dennischang928/Robot-Sumo/Hardware/Circuit/BMS/README.md

# BMS

## List of Material

- JST-4-PTH
- Schottky diode 1N5819HW-7
- Pre-charge PMOS FDS4685
- Reverse polarity protection NMOS AO3400
- PESD12VL1BA
