dennischang928/Robot-Sumo/Hardware/CAD/Manufacture/CNC/LEFT.dxf

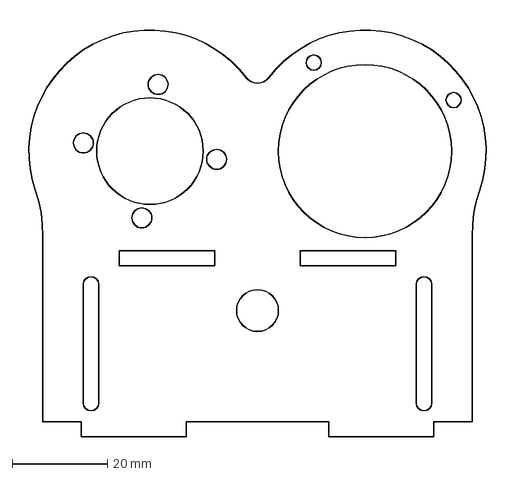
[picture p1: CAD file, 2023-05-18]
Hardware/CAD/Manufacture/CNC/LEFT.dxf
101.4 x 88.3 mm
