dennischang928/Robot-Sumo/Hardware/CAD/Manufacture/STL/Gear_2_be_Drive.stl

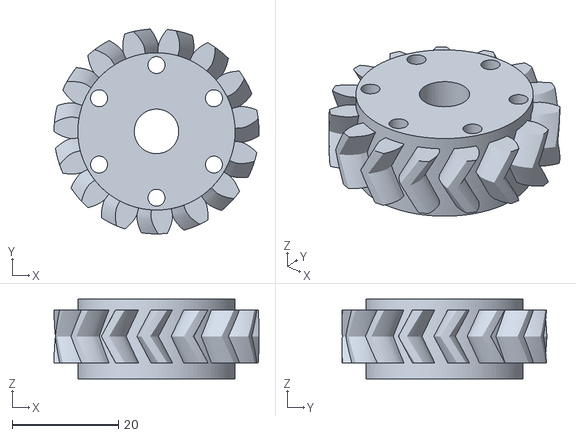
[picture p2: CAD file, 2023-05-18]
Hardware/CAD/Manufacture/STL/Gear_2_be_Drive.stl
38.6 x 38.6 x 15.0
