dennischang928/Robot-Sumo/Hardware/CAD/Manufacture/CNC/RIGHT.dxf

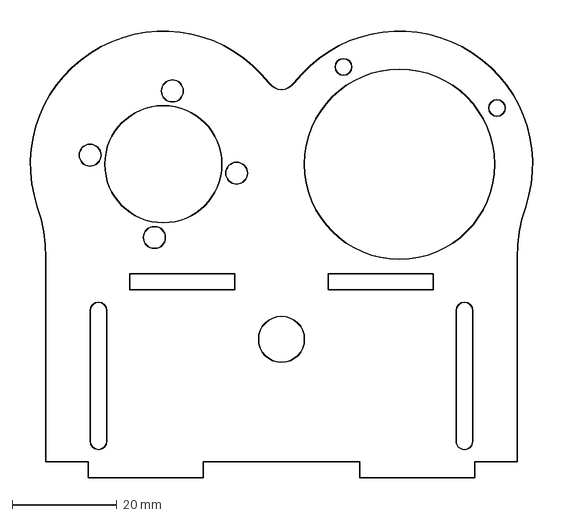
[picture p3: CAD file, 2023-05-18]
Hardware/CAD/Manufacture/CNC/RIGHT.dxf
101.4 x 88.3 mm
