dennischang928/Robot-Sumo/Hardware/CAD/Manufacture/STL/Motor_Gear(Drive Gear).stl

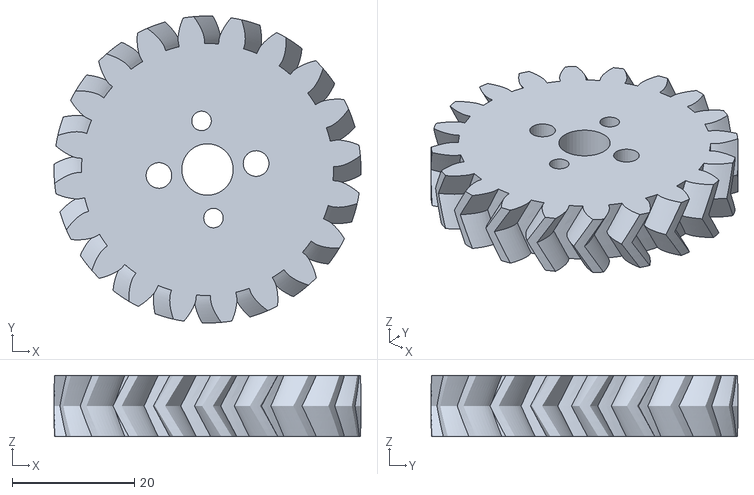
[picture p4: CAD file, 2023-05-18]
Hardware/CAD/Manufacture/STL/Motor_Gear(Drive Gear).stl
50.2 x 50.2 x 10.0
