dennischang928/Robot-Sumo/Hardware/CAD/Manufacture/STL/Wheel_Holder.stl

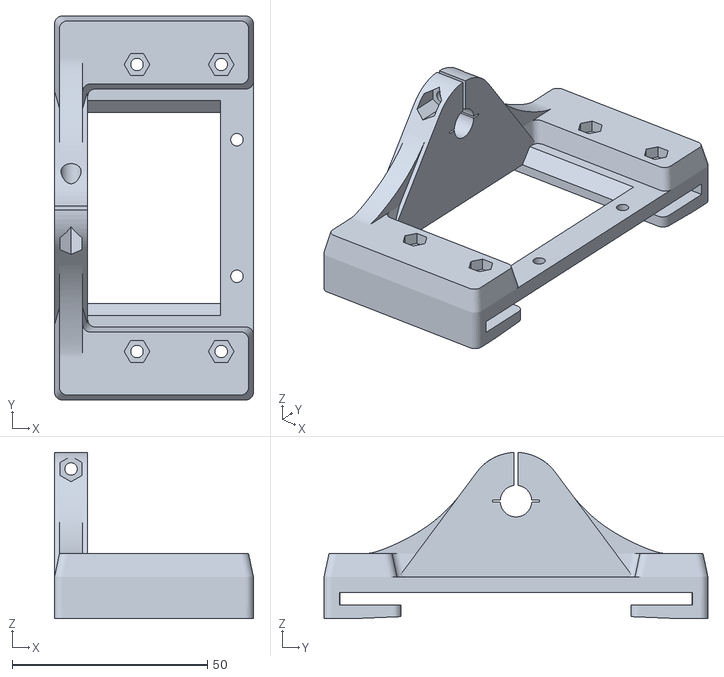
[picture p5: CAD file, 2023-05-18]
Hardware/CAD/Manufacture/STL/Wheel_Holder.stl
51.0 x 98.4 x 42.6
