dennischang928/Robot-Sumo/Hardware/CAD/Manufacture/CNC/Base.dxf

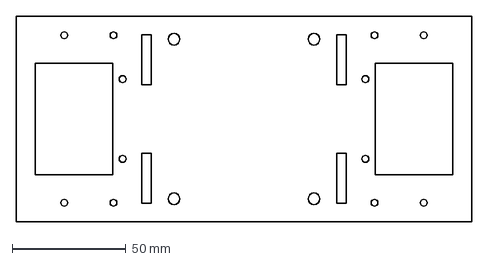
[picture p6: CAD file, 2023-05-18]
Hardware/CAD/Manufacture/CNC/Base.dxf
200.0 x 90.0 mm
