dennischang928/Robot-Sumo/Hardware/CAD/Manufacture/STL/Motor_Clamp.stl

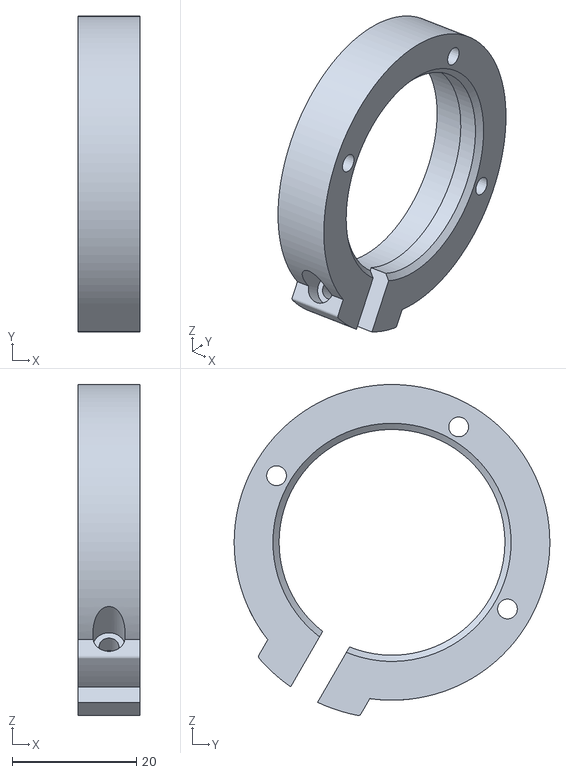
[picture p7: CAD file, 2023-05-18]
Hardware/CAD/Manufacture/STL/Motor_Clamp.stl
10.0 x 50.9 x 53.4
