dennischang928/Robot-Sumo/Hardware/CAD/Manufacture/CNC/Mid_part.dxf

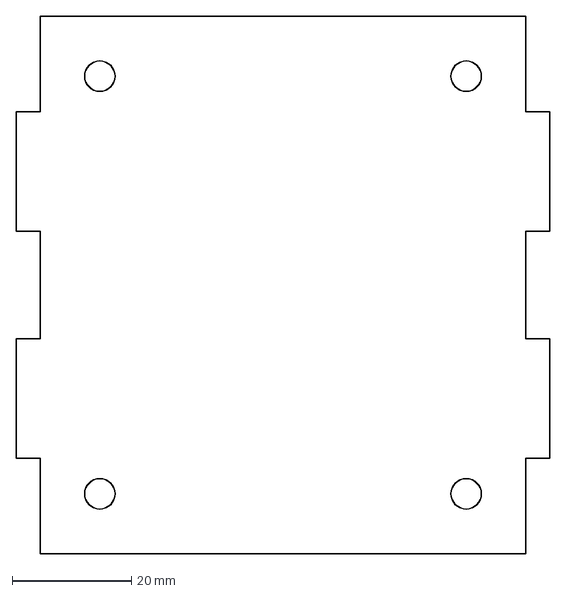
[picture p8: CAD file, 2023-05-18]
Hardware/CAD/Manufacture/CNC/Mid_part.dxf
89.4 x 90.0 mm
