dennischang928/Robot-Sumo/(list of files, cad)

Other CAD files:
Hardware/CAD/Manufacture/CNC/4mm.dwg
Hardware/CAD/Manufacture/CNC/3mm.dwg
