dennischang928/Robot-Sumo/Hardware/Circuit/SensorBrd/sch-SensorControlBrd v15.pdf

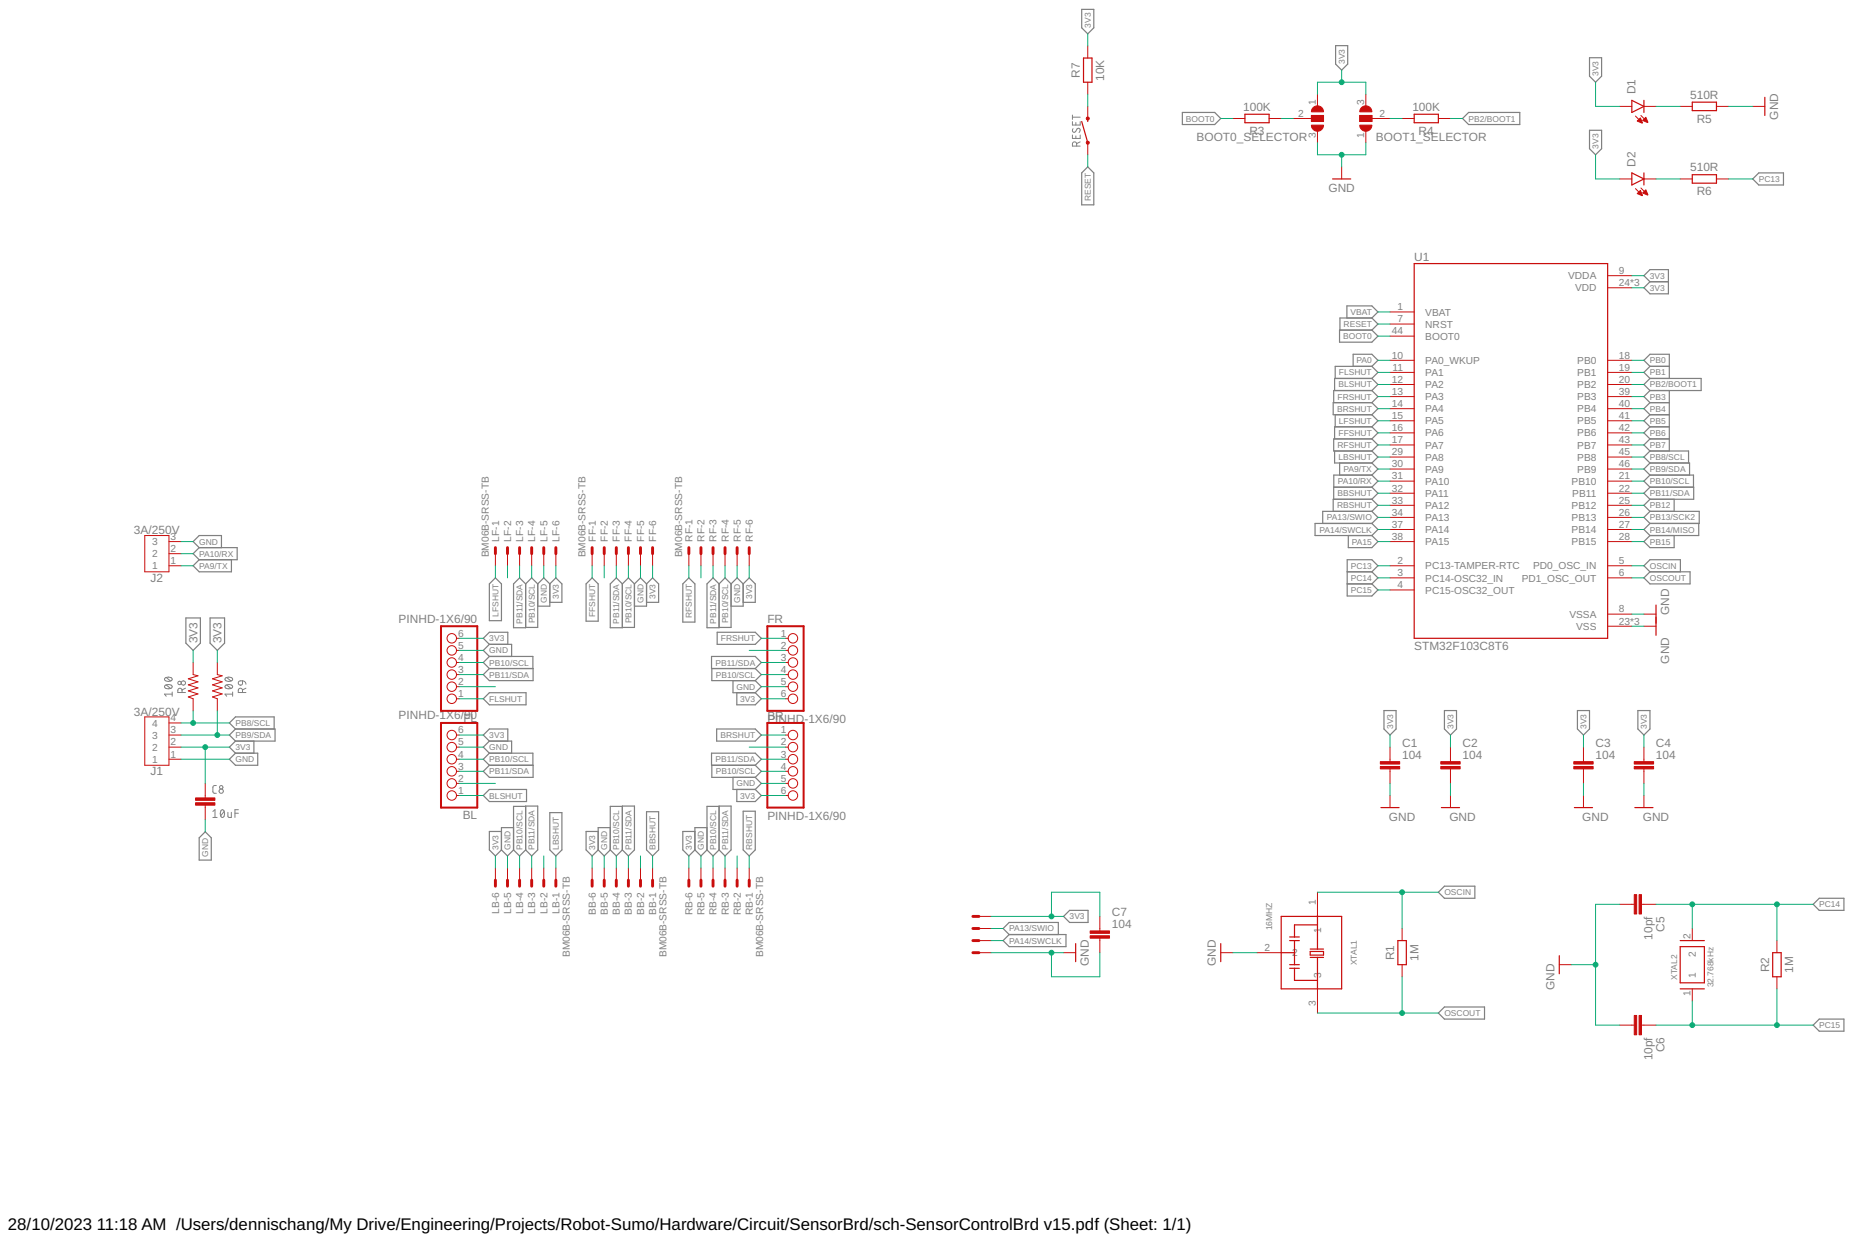
[picture p9: page 1]

28/10/2023 11:18 AM /Users/dennischang/My Drive/Engineering/Projects/Robot-Sumo/Hardware/Circuit/SensorBrd/sch-SensorControlBrd v15.pdf (Sheet: 1/1)
