dennischang928/Robot-Sumo/Hardware/Circuit/BMS/BMS_Schematic.pdf

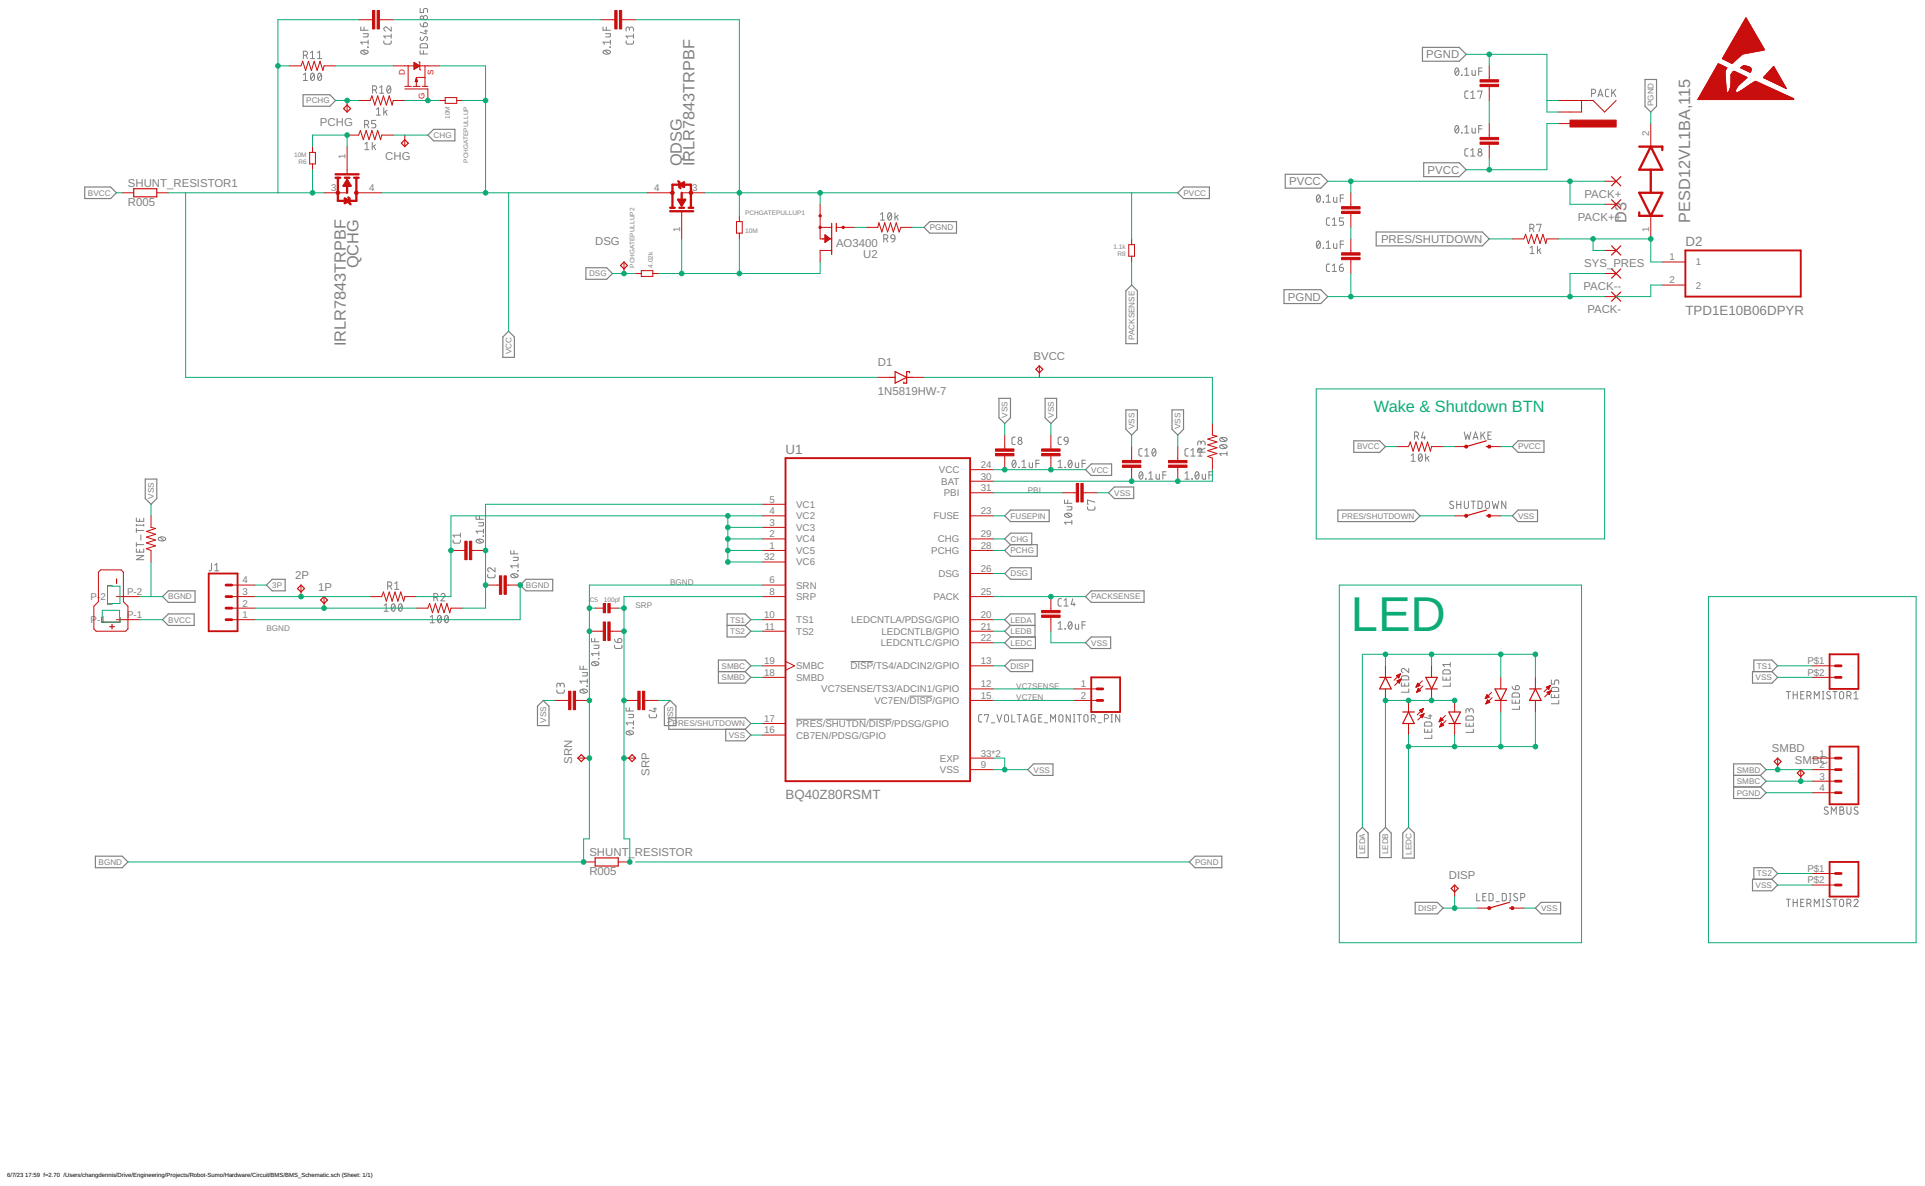
[picture p10: page 1]

6/7/23 17:59 f=2.70 /Users/changdennis/Drive/Engineering/Projects/Robot-Sumo/Hardware/Circuit/BMS/BMS_Schematic.sch (Sheet: 1/1)
