dennischang928/Robot-Sumo/Hardware/CAD/Manufacture/CNC/Assembly.pdf

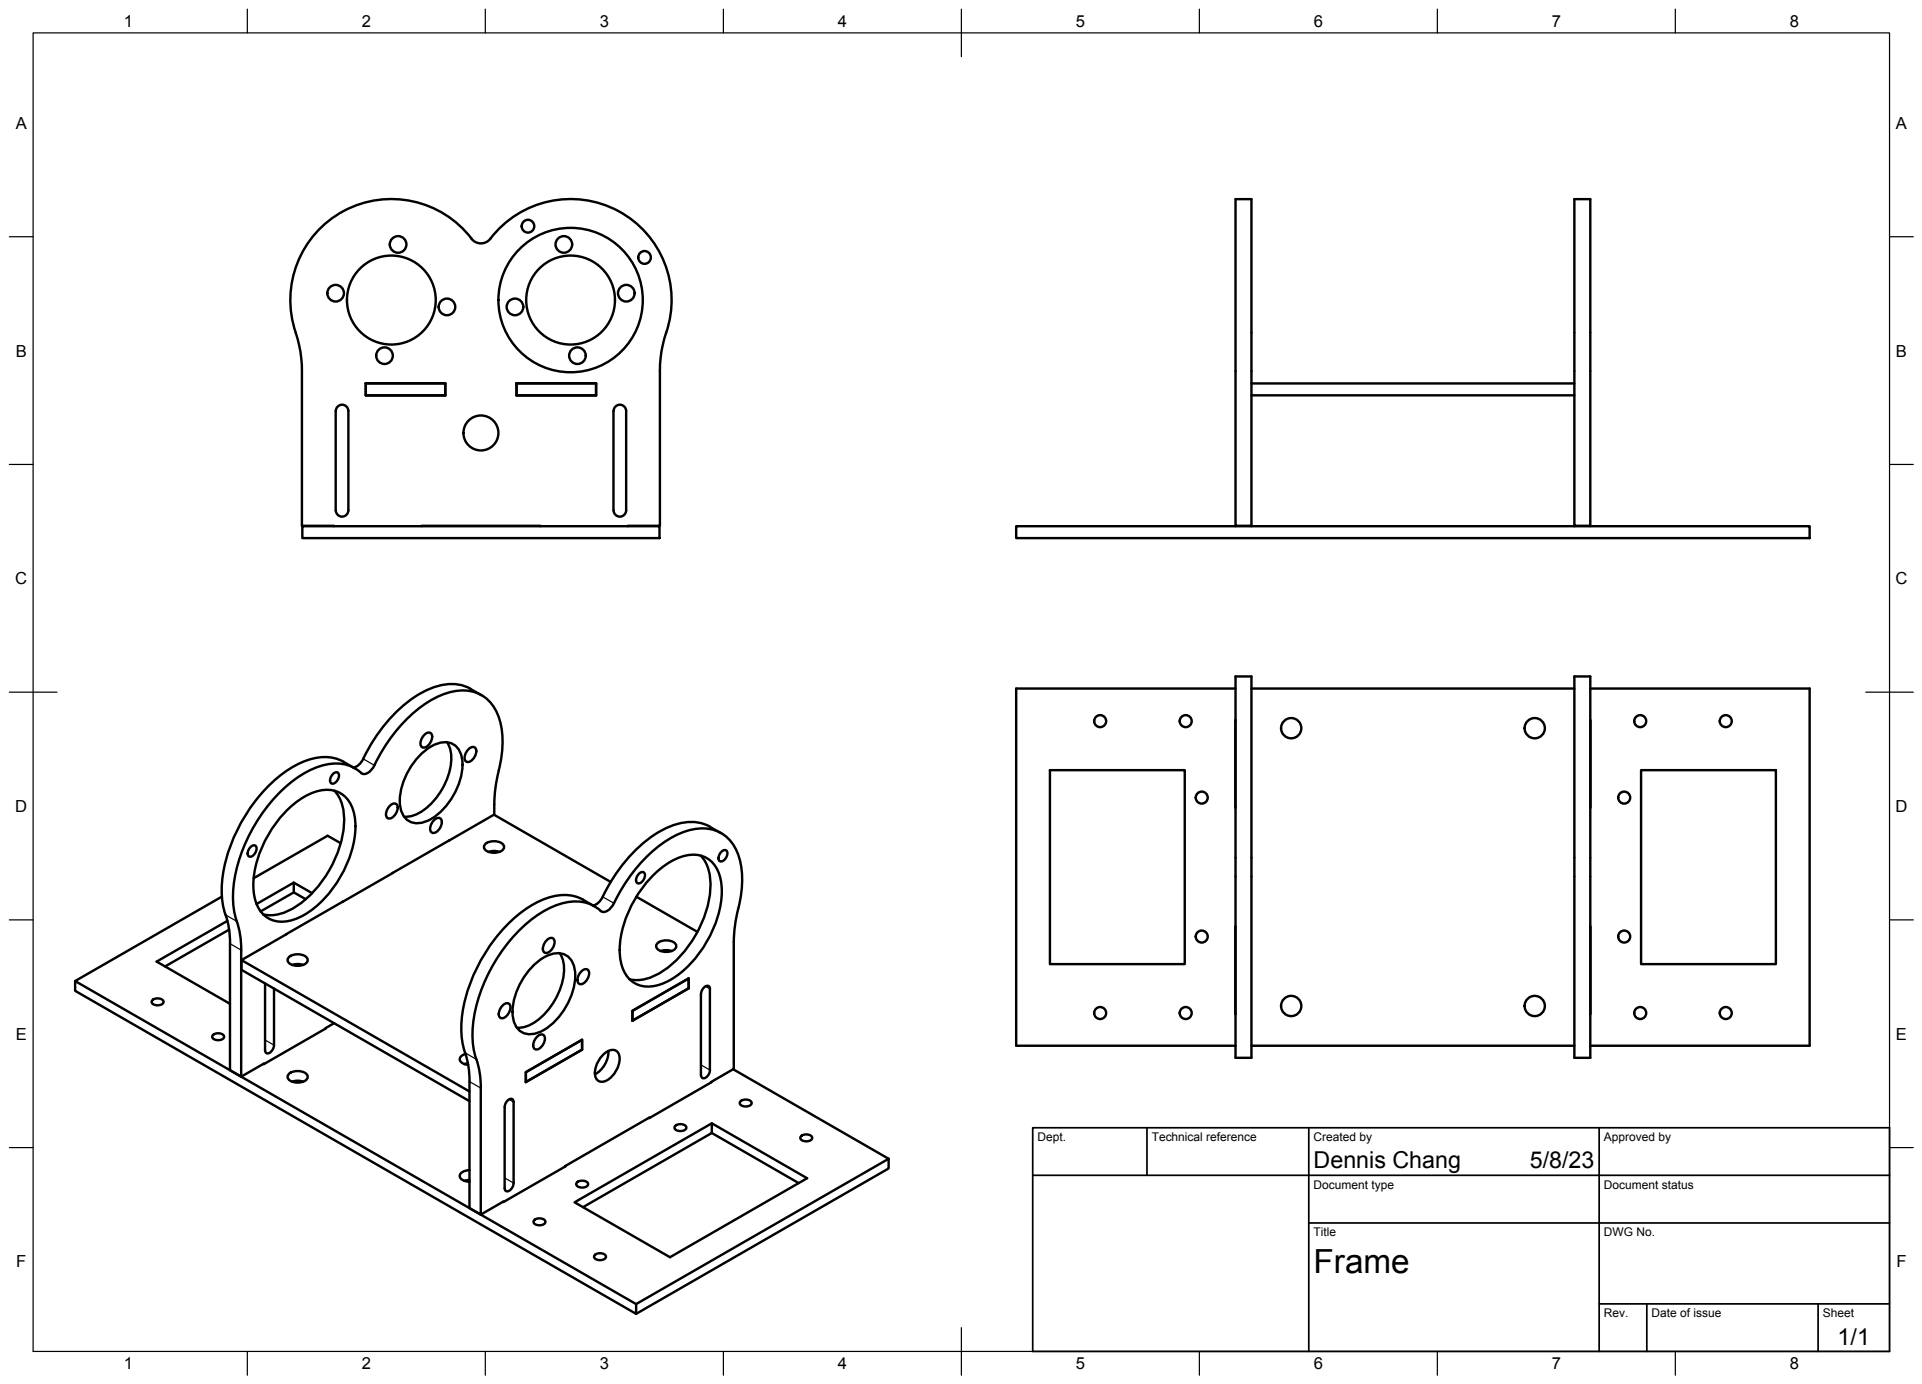
[picture p11: page 1]
Title; DWG No.; Rev.; Date of issue; Sheet

Dept. | Technical reference | Created by Dennis Chang 5/8/23 | Approved by

Document type | Document status
