dennischang928/Robot-Sumo/Hardware/Circuit/BMS/BMS_Schematic.brd

## EAGLE design Hardware/Circuit/BMS/BMS_Schematic.brd (2023-06-10)

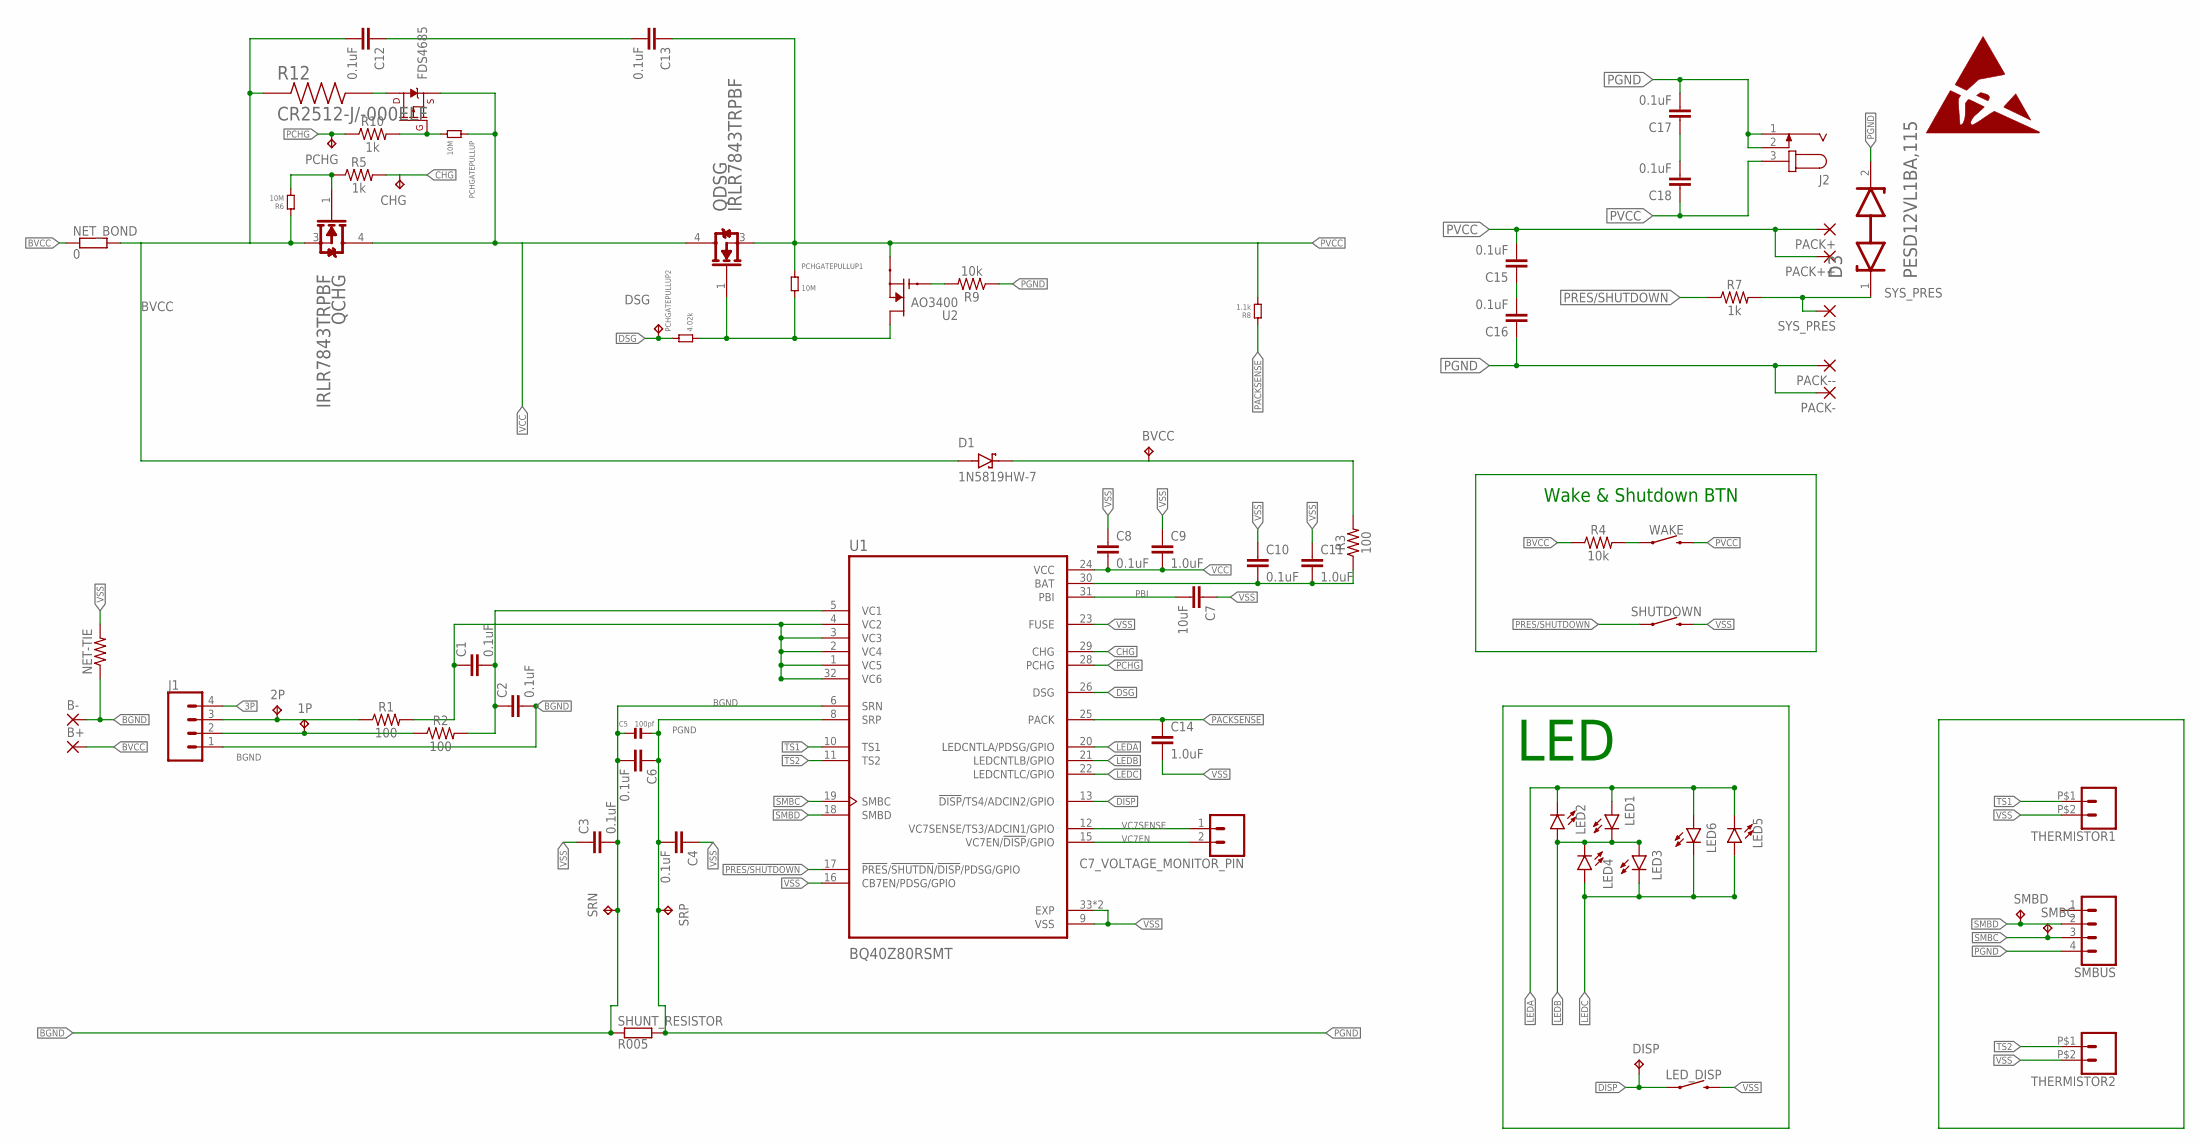
[picture p12: schematic BMS_Schematic.sch]

Parts:
1P, 2P: TPTP10R; TP10R
B+: WIREPADSMD5-2,5; 5-2,5
B-: WIREPADSMD5-2,5; 5-2,5
BVCC: TPTP10R; TP10R
C1, C2, C3, C4, C6, C8, C10, C12, C13, C15, C16, C17, C18: 0.1uF; 0603
C5: 100pf; 0805
C7: 10uF; 0603
C7_VOLTAGE_MONITOR_PIN: CONN_02; 1X02
C9, C11, C14: 1.0uF; 0603
CHG: TPTP10R; TP10R
D1: 1N5819HW-7; SOD3715X145N
D3: NEXPERIA_PESD12VL1BA,115NEXPERIA_PESD12VL1BA,115_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; NEXPERIA_PESD12VL1BA,115_0
DISP: TPTP10R; TP10R
DSG: TPTP10R; TP10R
J1: CONN_04JST-PTH; JST-4-PTH
J2: JACK-PLUG0; SPC4077
LED1, LED2, LED3, LED4, LED5, LED6: GREEN; LED-0603
LED_DISP: MOMENTARY-SWITCH-SPST-SMD-6.0X3.5MM; TACTILE_SWITCH_SMD_6.0X3.5MM
NET-TIE: 0; 0402-TIGHT
NET_BOND: 0; BVS
PACK+: WIREPADSMD5-2,5; 5-2,5
PACK++: WIREPADSMD5-2,5; 5-2,5
PACK-: WIREPADSMD5-2,5; 5-2,5
PACK--: WIREPADSMD5-2,5; 5-2,5
PCHG: TPTP10R; TP10R
PCHGATEPULLUP, PCHGATEPULLUP1: 10M; 0805
PCHGATEPULLUP2: 4.02k; 0805
QCHG: INFINEON_IRLR7843TRPBFINFINEON_IRLR7843TRPBF_0_0; INFINEON_IRLR7843TRPBF_0
QDSG: INFINEON_IRLR7843TRPBFINFINEON_IRLR7843TRPBF_0_0; INFINEON_IRLR7843TRPBF_0
R1, R2, R3: 100; 0603
R4, R9: 10k; 0603
R5, R7, R10: 1k; 0603
R6: 10M; 0805
R8: 1.1k; 0805
R12: CR2512-J/-000ELF; RESC6331X75N
SHUNT_RESISTOR: R005; BVS
SHUTDOWN: MOMENTARY-SWITCH-SPST-SMD-6.0X3.5MM; TACTILE_SWITCH_SMD_6.0X3.5MM
SMBC: TPTP10R; TP10R
SMBD: TPTP10R; TP10R
SMBUS: CONN_04JST-SMD-LOCKING; JST-4-SMD-1.25MM-LOCKING
SRN: TPTP10R; TP10R
SRP: TPTP10R; TP10R
SYS_PRES: SMD2; SMD1,27-2,54
THERMISTOR1, THERMISTOR2: SOLDER_PAD_2
U1: BQ40Z80RSMT; QFN40P400X400X100-33N
U2: AO3400; SOT23
U$2: FDS4685; SOIC127P600X150-8N
WAKE: MOMENTARY-SWITCH-SPST-SMD-6.0X3.5MM; TACTILE_SWITCH_SMD_6.0X3.5MM

Connections:
1P: C1.2, C2.1, R2.2, U1.5 (VC1)
2P: C1.1, R1.2, U1.1 (VC5), U1.2 (VC4), U1.3 (VC3), U1.4 (VC2), U1.32 (VC6)
3P: J1.4
BAT: C10.2, C11.2, R3.1, U1.30 (BAT)
BGND: B-.1, C2.2, C3.2, C5.1, C6.2, J1.1, NET-TIE.1, SHUNT_RESISTOR.2, SRN.TP, U1.6 (SRN)
BVCC: B+.1, C12.2, D1.A, NET_BOND.1, NET_BOND.2, QCHG.3 (SOURCE), R4.1, R6.1, R12.1
CHG: CHG.TP, R5.2, U1.29 (CHG)
DISP: DISP.TP, LED_DISP.1, U1.13 (!DISP!/TS4/ADCIN2/GPIO)
DSG: DSG.TP, PCHGATEPULLUP2.1, U1.26 (DSG)
LEDA: LED1.A, LED2.C, LED5.C, LED6.A, U1.20 (LEDCNTLA/PDSG/GPIO)
LEDB: LED1.C, LED2.A, LED3.A, LED4.C, U1.21 (LEDCNTLB/GPIO)
LEDC: LED3.C, LED4.A, LED5.A, LED6.C, U1.22 (LEDCNTLC/GPIO)
unnamed: R9.2, U2.1 (G)
unnamed: 2P.TP, J1.3, R1.1
unnamed: 1P.TP, J1.2, R2.1
unnamed: C12.1, C13.2
unnamed: BVCC.TP, D1.C (K), R3.2
unnamed: R12.2, U$2.5 (D), U$2.6 (D), U$2.7 (D), U$2.8 (D)
unnamed: PCHGATEPULLUP.2, R10.2, U$2.4 (G)
unnamed: QCHG.1 (GATE), R5.1, R6.2
unnamed: PCHGATEPULLUP1.2, PCHGATEPULLUP2.2, QDSG.1 (GATE), U2.3 (D)
unnamed: R4.2, WAKE.1
unnamed: C15.1, C16.2
unnamed: C17.1, C18.2
PACKSENSE: C14.1, R8.1, U1.25 (PACK)
PBI: C7.2, U1.31 (PBI)
PCHG: PCHG.TP, R10.1, U1.28 (PCHG)
PGND: C4.2, C5.2, C6.1, C16.1, C17.2, D3.2 (CATHODE_2), J2.1, J2.2, PACK-.1, PACK--.1, R9.1, SHUNT_RESISTOR.1, SMBUS.4, SRP.TP, U1.8 (SRP)
PRES/SHUTDOWN: R7.1, SHUTDOWN.1, U1.17 (!PRES!/!SHUTDN!/!DISP!/PDSG/GPIO)
PVCC: C13.1, C15.2, C18.1, J2.3, PACK+.1, PACK++.1, PCHGATEPULLUP1.1, QDSG.3 (SOURCE), R8.2, U2.2 (S), WAKE.2
SMBC: SMBC.TP, SMBUS.3, U1.19 (SMBC)
SMBD: SMBD.TP, SMBUS.2, U1.18 (SMBD)
SYS_PRES: D3.1 (CATHODE_1), R7.2, SYS_PRES.1
TS1: THERMISTOR1.P$1 (1), U1.10 (TS1)
TS2: THERMISTOR2.P$1 (1), U1.11 (TS2)
VC7EN: C7_VOLTAGE_MONITOR_PIN.2, U1.15 (VC7EN/!DISP!/GPIO)
VC7SENSE: C7_VOLTAGE_MONITOR_PIN.1, U1.12 (VC7SENSE/TS3/ADCIN1/GPIO)
VCC: C8.2, C9.2, PCHGATEPULLUP.1, QCHG.4 (DRAIN), QDSG.4 (DRAIN), U1.24 (VCC), U$2.1 (S), U$2.2 (S), U$2.3 (S)
VSS: C3.1, C4.1, C7.1, C8.1, C9.1, C10.1, C11.1, C14.2, LED_DISP.2, NET-TIE.2, SHUTDOWN.2, THERMISTOR1.P$2 (2), THERMISTOR2.P$2 (2), U1.9 (VSS), U1.16 (CB7EN/PDSG/GPIO), U1.23 (FUSE), U1.33 (EXP), U1.33_1 (EXP)

Notes on the sheet:
LED
Wake & Shutdown BTN

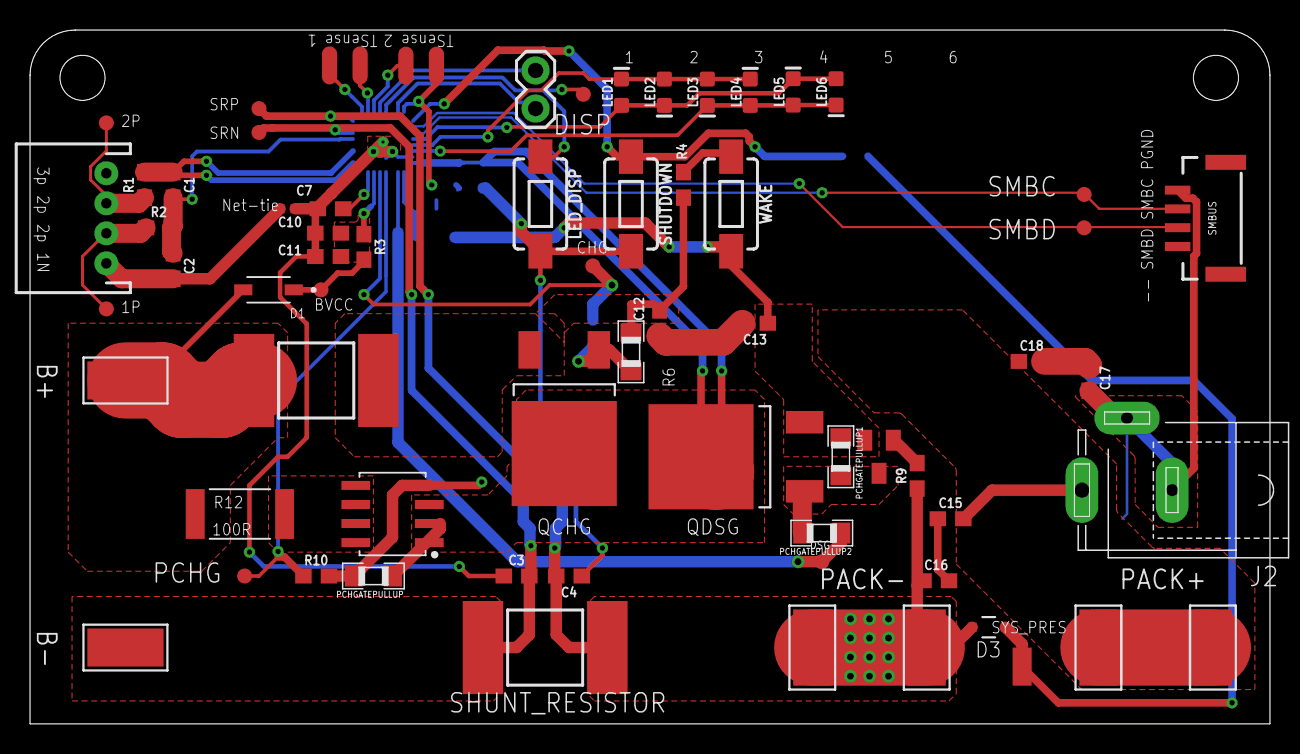
[picture p13: board BMS_Schematic.brd from above]

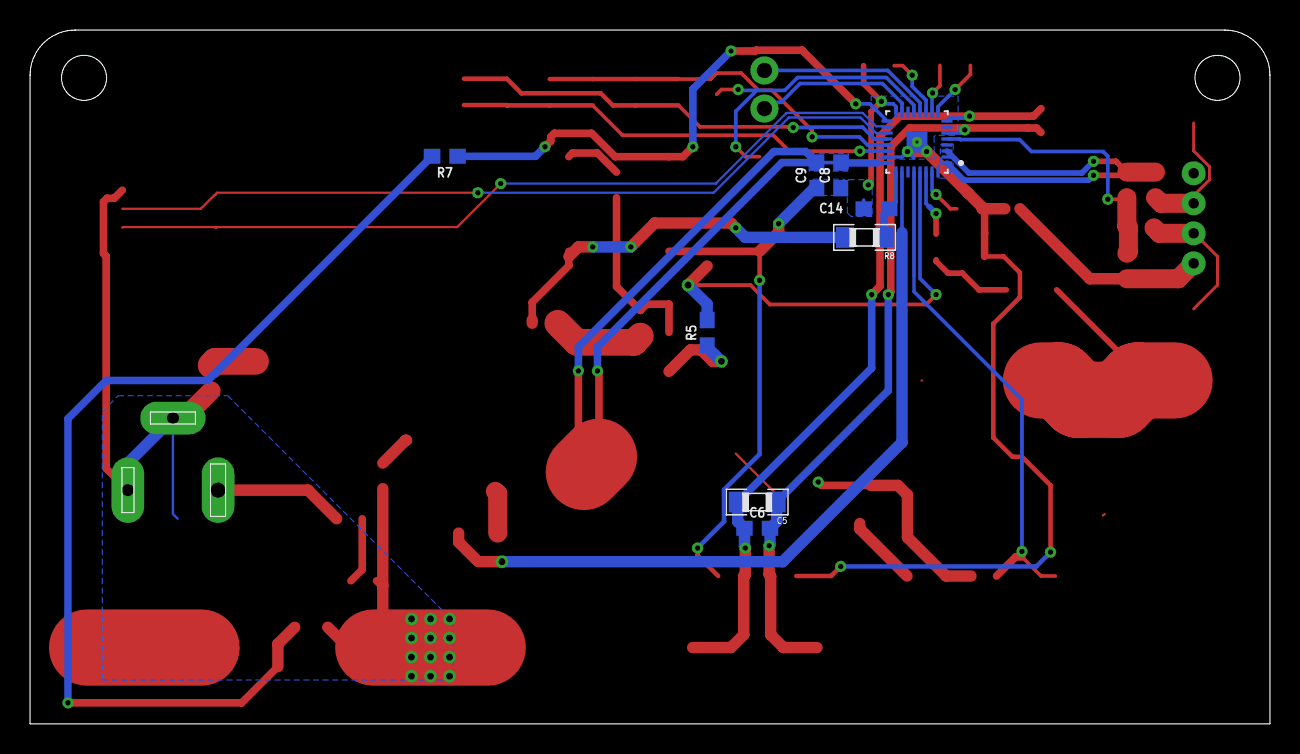
[picture p14: board BMS_Schematic.brd from below]

Board: 2 copper layers, 82.5 x 46.2 mm, 75 parts (9 on the bottom side), 38 nets.
