dennischang928/Robot-Sumo/Software/Tests/VL53l1x-Test/Core/Src/main.c

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
/* Includes ------------------------------------------------------------------*/
#include "main.h"

/* USER CODE BEGIN Includes */
#include "VL53L1X_api.h"
#include <stdbool.h>

/* USER CODE END Includes */

/* USER CODE BEGIN PD */
#define SensorNumber 1
/* USER CODE END PD */

I2C_HandleTypeDef hi2c2;

UART_HandleTypeDef huart1;

/* USER CODE BEGIN PV */

VL53L1_Dev_t devs[SensorNumber];
uint8_t		DevicesAddresses[SensorNumber] = {0x50, 0x02};
int			status = 0;

uint8_t		sensorState = 0;
uint16_t Distance;
uint16_t SignalRate;
uint16_t AmbientRate;
uint16_t AmbientPerSpad;
uint8_t RangeStatus;
/* USER CODE END PV */

void	SystemClock_Config(void);
static void	MX_GPIO_Init(void);
static void	MX_USART1_UART_Init(void);
static void	MX_I2C2_Init(void);
/* USER CODE BEGIN PFP */

void	EnableSensor(VL53L1_Dev_t *device)
{
	HAL_GPIO_WritePin((*device).XSHUT_GPIO, (*device).XSHUT_PIN, GPIO_PIN_SET);
}

void	DisableSensor(VL53L1_Dev_t *device)
{
	HAL_GPIO_WritePin((*device).XSHUT_GPIO, (*device).XSHUT_PIN,
			GPIO_PIN_RESET);
}

ssize_t	_write(int fd, const char *buf, size_t nbyte)
{
	HAL_UART_Transmit(&huart1, (uint8_t *)buf, nbyte, 10);
	return (nbyte);
}

void	GetMeasurements(VL53L1_Dev_t *device)
{
	// GetMeasurements of: range status, distance, signal rate
	status = VL53L1X_GetRangeStatus(*device, &RangeStatus);
	status = VL53L1X_GetDistance(*device, &Distance);
	status = VL53L1X_GetSignalRate(*device, &SignalRate);
	status = VL53L1X_GetAmbientRate(*device, &AmbientRate);
	status = VL53L1X_GetAmbientPerSpad(*device, &AmbientPerSpad);

	printf("RangeStatus: %u, ", RangeStatus);
	printf("Distance: %u, ", Distance);
	printf("SignalRate: %u, ", SignalRate);
	printf("AmbientPerSpad: %u\n\r", AmbientPerSpad);
}

void	SetDeviceAddress(VL53L1_Dev_t *device, uint8_t NewAddress)
{
	VL53L1X_SetI2CAddress(*device, NewAddress);
	(*device).I2cDevAddr = NewAddress;
}

void	InitSensor(VL53L1_Dev_t *device, uint8_t AddressToAssign)
{ // Boot up and initialize the device and assign a new addr to the device.
	EnableSensor(device);
	printf("DeviceXSHUTBooted\n\r");
	status = VL53L1X_SensorInit(*device);
	SetDeviceAddress(device, AddressToAssign);
	printf("DeviceNewAddr: %X\n\r", (*device).I2cDevAddr);

	uint8_t byteData;
	status = VL53L1_RdByte(device, 0x010F, &byteData);
	printf("VL53L1X Model_ID: %X\n\r", byteData);
	status = VL53L1_RdByte(device, 0x0110, &byteData);
	printf("VL53L1X Module_Type: %X\n\r", byteData);

	while (sensorState == 0)
	{
		status = VL53L1X_BootState(*device, &sensorState);
		HAL_Delay(2);
		printf("Chip failed to boot\n\r");
	}

	printf("Chip booted\n\r");

	status = VL53L1X_SetDistanceMode(*device, 1); /* 1=short, 2=long */
	status = VL53L1X_SetROI(*device, 4, 5);       /* minimum ROI 4,4 */
}

/* USER CODE END PFP */

/**
  * @brief  The application entry point.
  * @retval int
  */
int	main(void)
{
	/* USER CODE BEGIN 1 */
	void InitAllSensors2Ranging()
	{
		for (int i = 0; i < SensorNumber; i++)
		{
			DisableSensor(&(devs[i]));
		}

		for (int i = 0; i < SensorNumber; i++)
		{
			EnableSensor(&(devs[i]));
			InitSensor(&(devs[i]), DevicesAddresses[i]);
			status = VL53L1X_StartRanging(devs[i]);
		}
	}
	/* USER CODE END 1 */

	/* MCU Configuration--------------------------------------------------------*/

	/* Reset of all peripherals,
		Initializes the Flash interface and the Systick. */
	HAL_Init();

	/* USER CODE BEGIN Init */

	for (int i = 0; i < SensorNumber; i++)
	{
		devs[i].I2cHandle = &hi2c2;
		devs[i].I2cDevAddr = 0x52;
	}

	devs[0].XSHUT_GPIO = Dev2_GPIO_Port;
	// devs[1].XSHUT_GPIO = Dev2_GPIO_Port;

	devs[0].XSHUT_PIN = Dev2_Pin;
	// devs[1].XSHUT_PIN = Dev2_Pin;
	/* USER CODE END Init */

	/* Configure the system clock */
	SystemClock_Config();

	/* Initialize all configured peripherals */
	MX_GPIO_Init();
	MX_USART1_UART_Init();
	MX_I2C2_Init();
	/* USER CODE BEGIN 2 */

	InitAllSensors2Ranging();

	/* USER CODE END 2 */

	/* Infinite loop */
	/* USER CODE BEGIN WHILE */
	while (1)
	{
		/* USER CODE END WHILE */

		/* USER CODE BEGIN 3 */
		status = VL53L1X_GetDistance(devs[0], &Distance);
		printf("Dev0: %u, ", Distance );
		// status = VL53L1X_GetDistance(devs[1], &Distance);
		// printf("Dev1: %u", Distance);
		printf("\n\r");
	}
	/* USER CODE END 3 */
}

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
