dennischang928/Robot-Sumo/Software/MultiMCUsTest/I2CRx/I2CRx.ioc

Mcu.UserName=STM32F103C8Tx
PA10.Signal=USART1_RX
PA9.Signal=USART1_TX
PB10.Signal=I2C2_SCL
PB11.Signal=I2C2_SDA
PB8.Signal=I2C1_SCL
PB9.Signal=I2C1_SDA
