dennischang928/Robot-Sumo/Software/Tests/VL53l1x-Test/Core/Inc/main.h

#define LED_PIN_Pin GPIO_PIN_13
#define LED_PIN_GPIO_Port GPIOC
#define Dev1_Pin GPIO_PIN_12
#define Dev1_GPIO_Port GPIOB
#define Dev2_Pin GPIO_PIN_8
#define Dev2_GPIO_Port GPIOA
