dennischang928/Robot-Sumo/(commit log)

2023-05-18 Changing [CAD] directory [Gcode, CNC, STL] position
    [3mm.dwg, 4mm.dwg, Base.dxf, Gear_2_be_Drive.stl, LEFT.dxf, Mid_part.dxf, Motor_Clamp.stl, Motor_Gear(Drive Gear).stl]
2023-05-18 Finish designing the robot's gear box
2023-06-10 Finalize B.M.S Mark1 PCB design with all components and connections
    [BMS_Schematic.brd, BMS_Schematic.sch]
2023-08-19 Testing communication between two stm32 inside [MultiMCUsTest] folder, originally planned to use spi as the interface for data transfer. Failed
    [MotherBoardTest.ioc, MotherBrdRx.ioc, SensorBrdTx.ioc, VL53l1x-Test.ioc, main.c, main.h, vl53l1_platform.c]
2023-08-21 Testing communication between two stm32 inside [MultiMCUsTest] folder, failed to use CAN as the interface. Using I2C in the future
    [CANRx.ioc, CANTx.ioc, main.c, main.h]
2023-08-22 Succeed to test communication between two stm32 inside [MultiMCUsTest] folder with I2C as the interface
2023-08-22 Update README.md
    Update the method of communication between sensorBrd and MotherBrd from SPI simplex to I2C
2023-08-22 Sensor-Mother Brd communciation: succeed to send multi(eight) bytes together
